jklee341/ece445_project/README.md

# Rodent Deterrent and Classification System

Rodent deterrent and classification system
