jklee341/ece445_project/boards/445project.kicad_pcb

## KiCad design boards/445project.kicad_pcb (2024-03-05)

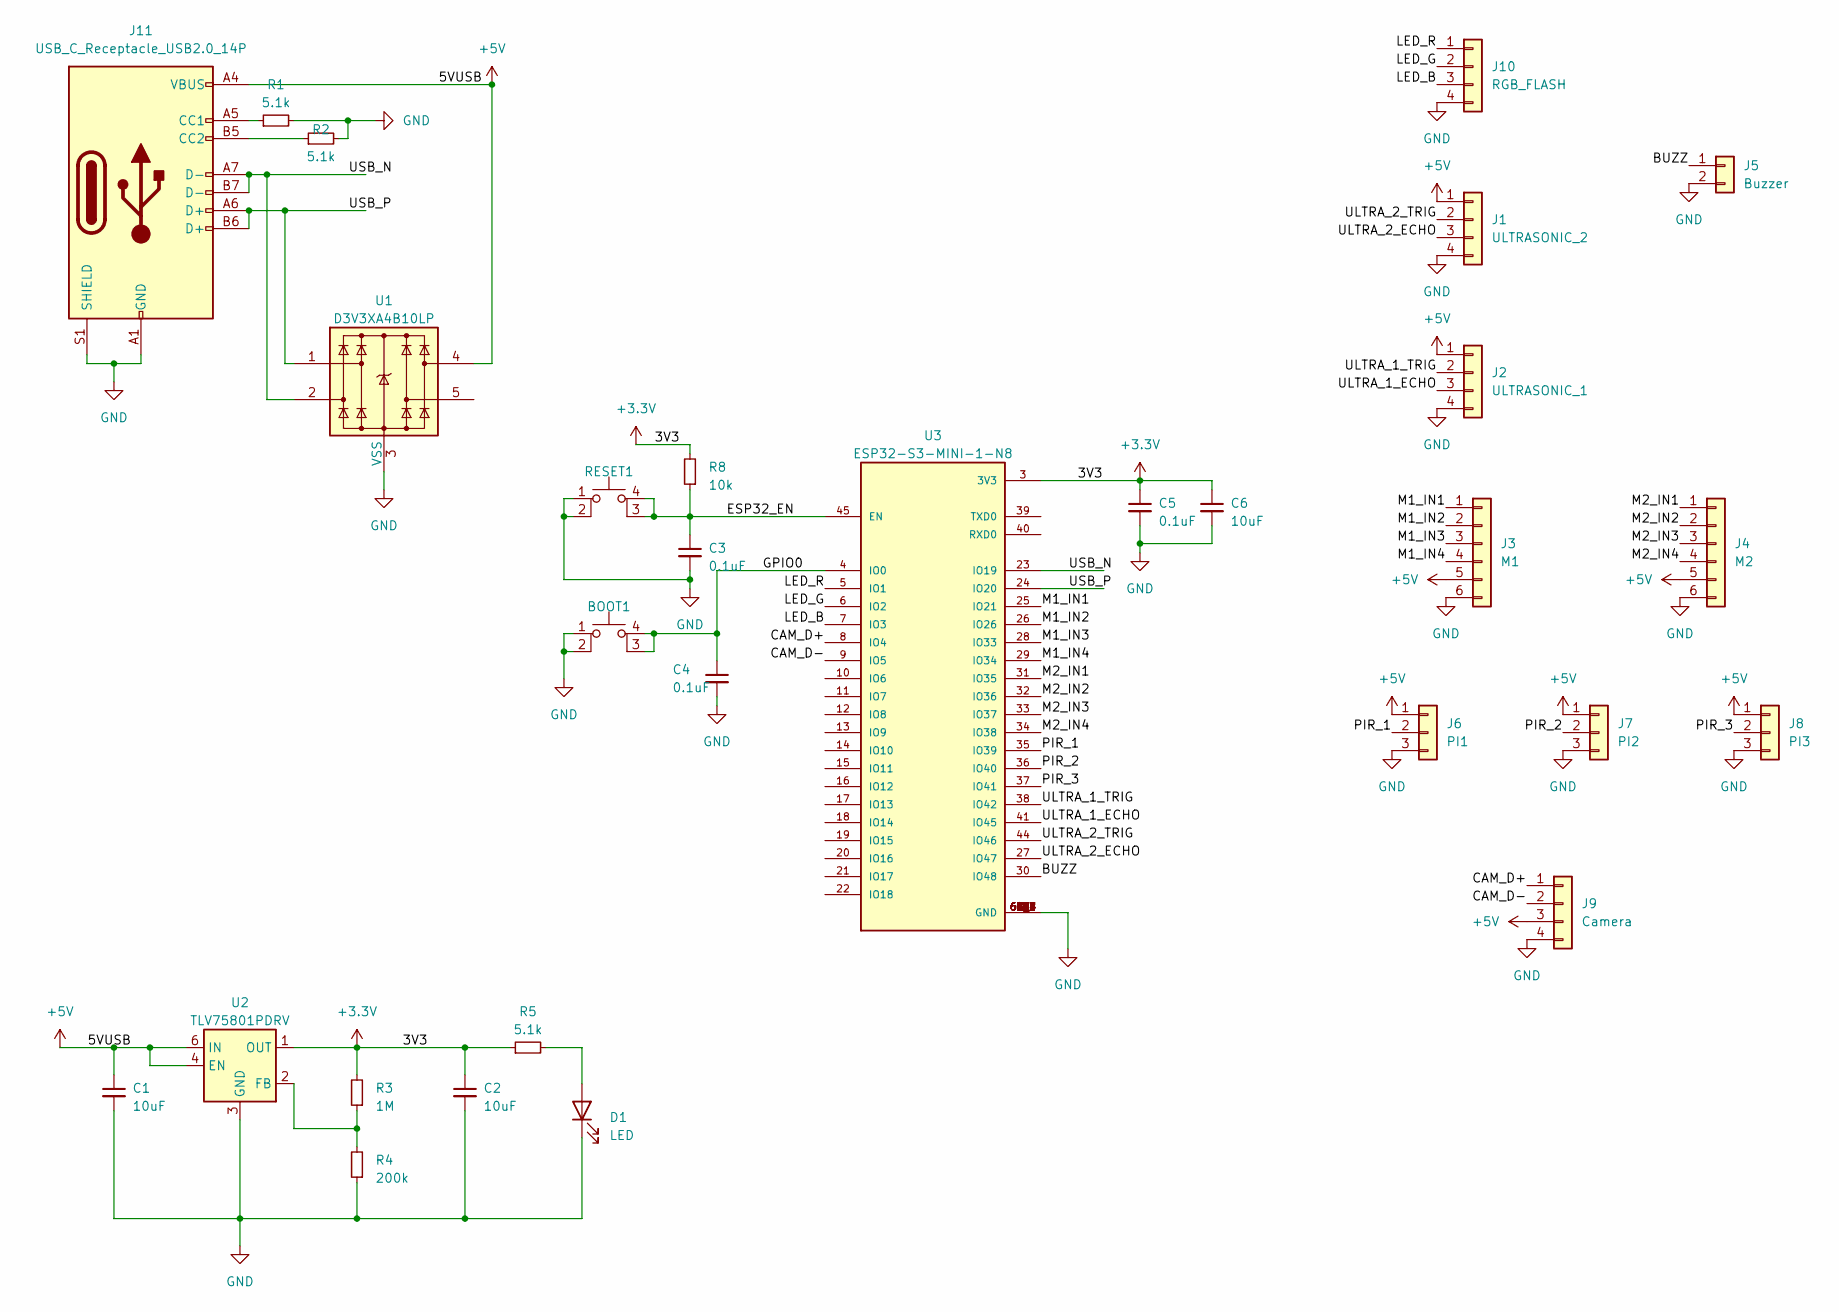
[picture p10: schematic 445project.kicad_sch]

Parts:
BOOT1: SW_SPST_PTS810
C1, C2, C6: 10uF; C_0603_1608Metric
C3, C4, C5: 0.1uF; C_0603_1608Metric
D1: LED; LED_0603_1608Metric
J1: ULTRASONIC_2; PinHeader_1x04_P2.54mm_Vertical
J2: ULTRASONIC_1; PinHeader_1x04_P2.54mm_Vertical
J3: M1; PinHeader_1x06_P2.54mm_Vertical
J4: M2; PinHeader_1x06_P2.54mm_Vertical
J5: Buzzer; PinHeader_1x02_P2.54mm_Vertical
J6: PI1; PinHeader_1x03_P2.54mm_Vertical
J7: PI2; PinHeader_1x03_P2.54mm_Vertical
J8: PI3; PinHeader_1x03_P2.54mm_Vertical
J9: Camera; PinHeader_1x04_P2.54mm_Vertical
J10: RGB_FLASH; PinHeader_1x04_P2.54mm_Vertical
J11: USB_C_Receptacle_USB2.0_14P; USB_C_Receptacle_GCT_USB4105-xx-A_16P_TopMnt_Horizontal
R1, R2, R5: 5.1k; R_0603_1608Metric
R3: 1M; R_0603_1608Metric
R4: 200k; R_0603_1608Metric
R8: 10k; R_0603_1608Metric
RESET1: SW_SPST_PTS810
U1: D3V3XA4B10LP; Diodes_UDFN-10_1.0x2.5mm_P0.5mm
U2: TLV75801PDRV; WSON-6-1EP_2x2mm_P0.65mm_EP1x1.6mm
U3: ESP32-S3-MINI-1-N8; XCVR_ESP32-S3-MINI-1-N8; PARTREV v0.6

Connections:
+3.3V: C2.1, C5.1, C6.1, R3.2, R5.1, R8.2, U2.1 (OUT), U3.3 (3V3)
+5V: C1.1, J1.1, J2.1, J3.5, J4.5, J6.1, J7.1, J8.1, J9.3, J11.A4 (VBUS), J11.A9 (VBUS), J11.B4 (VBUS), J11.B9 (VBUS), U1.4, U2.4 (EN), U2.6 (IN)
/BUZZ: J5.1, U3.30 (IO48)
/CAM_D+: J9.1, U3.8 (IO4)
/CAM_D-: J9.2, U3.9 (IO5)
/ESP32_EN: C3.1, R8.1, RESET1.3 (K), RESET1.4 (A), U3.45 (EN)
/GPIO0: BOOT1.3 (K), BOOT1.4 (A), C4.1, U3.4 (IO0)
/LED_B: J10.3, U3.7 (IO3)
/LED_G: J10.2, U3.6 (IO2)
/LED_R: J10.1, U3.5 (IO1)
/M1_IN1: J3.1, U3.25 (IO21)
/M1_IN2: J3.2, U3.26 (IO26)
/M1_IN3: J3.3, U3.28 (IO33)
/M1_IN4: J3.4, U3.29 (IO34)
/M2_IN1: J4.1, U3.31 (IO35)
/M2_IN2: J4.2, U3.32 (IO36)
/M2_IN3: J4.3, U3.33 (IO37)
/M2_IN4: J4.4, U3.34 (IO38)
/PIR_1: J6.2, U3.35 (IO39)
/PIR_2: J7.2, U3.36 (IO40)
/PIR_3: J8.2, U3.37 (IO41)
/ULTRA_1_ECHO: J2.3, U3.41 (IO45)
/ULTRA_1_TRIG: J2.2, U3.38 (IO42)
/ULTRA_2_ECHO: J1.3, U3.27 (IO47)
/ULTRA_2_TRIG: J1.2, U3.44 (IO46)
/USB_N: J11.A7 (D-), J11.B7 (D-), U1.2, U3.23 (IO19)
/USB_P: J11.A6 (D+), J11.B6 (D+), U1.1, U3.24 (IO20)
GND: BOOT1.1, BOOT1.2, C1.2, C2.2, C3.2, C4.2, C5.2, C6.2, D1.1 (K), J1.4, J2.4, J3.6, J4.6, J5.2, J6.3, J7.3, J8.3, J9.4, J10.4, J11.A1 (GND), J11.A12 (GND), J11.B1 (GND), J11.B12 (GND), J11.S1 (SHIELD), R1.2, R2.2, R4.1, RESET1.1, RESET1.2, U1.3 (VSS), U1.8 (VSS), U2.3 (GND), U2.7 (GND), U3.1 (GND), U3.2 (GND), U3.42 (GND), U3.43 (GND), U3.46 (GND), U3.47 (GND), U3.48 (GND), U3.49 (GND), U3.50 (GND), U3.51 (GND), U3.52 (GND), U3.53 (GND), U3.54 (GND), U3.55 (GND), U3.56 (GND), U3.57 (GND), U3.58 (GND), U3.59 (GND), U3.60 (GND), U3.61 (GND), U3.61_1 (GND), U3.61_2 (GND), U3.61_3 (GND), U3.61_4 (GND), U3.61_5 (GND), U3.61_6 (GND), U3.61_7 (GND), U3.61_8 (GND), U3.62 (GND), U3.63 (GND), U3.64 (GND), U3.65 (GND)
unnamed: D1.2 (A), R5.2
unnamed: J11.A5 (CC1), R1.1
unnamed: J11.B5 (CC2), R2.1
unnamed: R3.1, R4.2, U2.2 (FB)

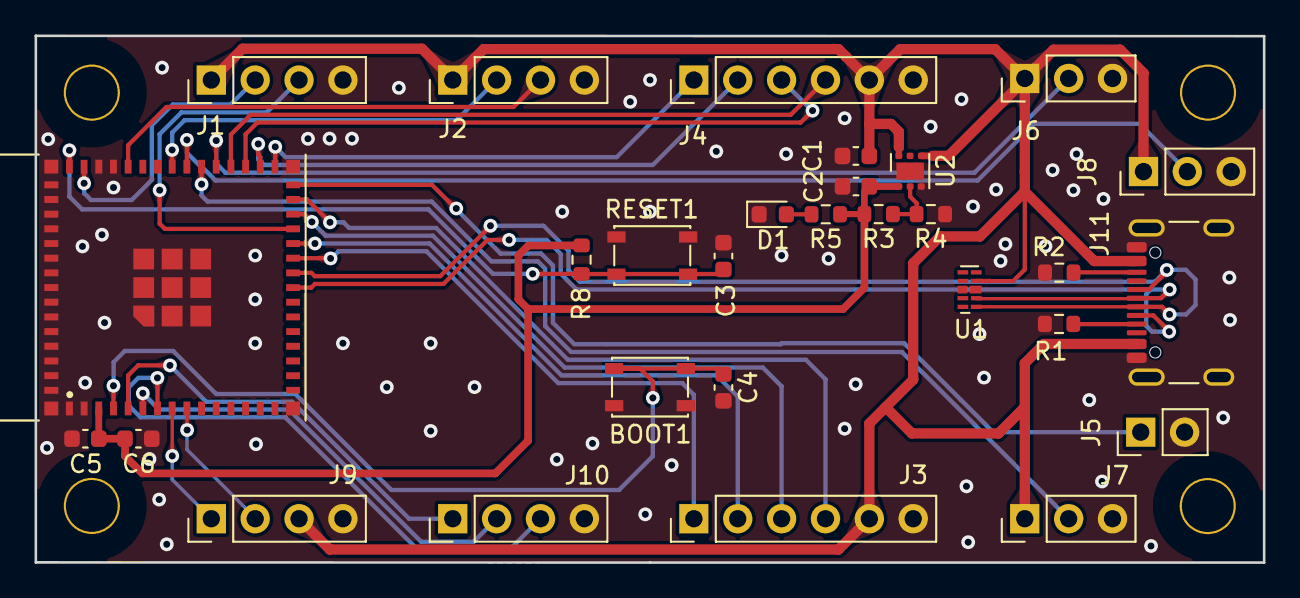
[picture p11: board 445project.kicad_pcb from above]

Board: 2 copper layers, 71.1 x 30.5 mm, 29 parts (0 on the bottom side), 32 nets.
