jklee341/ece445_project/(commit log)

2024-03-05 pcb schematic
    [445project.kicad_sch]
2024-03-05 pcb version 1
    [445project.kicad_pcb, 445project.kicad_sch]
2024-06-26 add ultrasonicsensor.py
2024-06-26 add servo.py
2024-06-26 add sensors.py
